Chamodya678442/5-DOF-Pick-Place-Robotic-Arm/Research Paper content/Latex_files/main.tex

\documentclass[conference]{IEEEtran}

\usepackage{cite}
\usepackage{amsmath,amsfonts}
\usepackage{amssymb}
\usepackage{graphicx}
\usepackage{url}
\usepackage{booktabs}
\usepackage{array}

\usepackage{tikz}
\usetikzlibrary{shapes.geometric, arrows.meta, positioning}

\makeatletter
\renewcommand{\subsection}{%
    \@startsection{subsection}{2}{\z@}%
    {2.5ex plus 1ex minus 0.2ex}%
    {1.0ex plus 0.2ex}%
    {\normalfont\normalsize\bfseries}%
}
\makeatother

\makeatletter
\renewcommand{\subsubsection}{%
    \@startsection{subsubsection}{3}{\z@}%
    {1.5ex plus 0.5ex minus 0.2ex}%
    {0.8ex plus 0.2ex}%
    {\normalfont\normalsize}%
}
\makeatother

\title{Design and Implementation of a 5-DOF Pick and Place Robotic Arm
}

\author{
    \IEEEauthorblockN{
        Abeywardhana S D,
        Chamodya B J,
        Hettiarachchi S M
    }
    \IEEEauthorblockA{
        Department of Computer Engineering\\
        Faculty of Engineering\\
        University of Sri Jayewardenepura\\
        Sri Lanka
    }
}

\begin{document}

\maketitle

\begin{abstract}
Automation of object handling tasks is a significant technological advancement in most of the modern world applications. This project carefully examines the design and the development of a five-degree-of-freedom (5 DOF) robotic arm which is specifically designed for automated pick-and-place operations. The main movements of the robotic arm is determined using inverse kinematics which is a mathematical process commonly used to calculate the required rotation angles of each joint based on the desired position of the end effector. The object detection system has been implemented to identify the target object and coordinate-based positioning is combined to achieve the required movements during this whole process. Mechanical and electronic simulations were also integrated and the system’s future implementations will develop this system further. This research is mainly focused on the integration of robotic kinematics, mechanical design and embedded control of the robotic arm.

\end{abstract}

\begin{IEEEkeywords}
Robotic arm, 5 DOF, Kinematics, Mechanical structure , Pick-and-place, Electronic system, Micro-controller, Object detection, Challenges and implementation

\end{IEEEkeywords}

\input{sections/introduction}

\input{sections/literature review}

\input{sections/system overview and architecture}

\input{sections/mechanical design and prototype development}

\input{sections/inverse kinematics model and angle calculation}

\input{sections/electronic system and microcontroller implementation}

\input{sections/experimental results and discussion}

\input{sections/conclusion}

\input{sections/future work}

\input{sections/acknowledgment}

\bibliographystyle{IEEEtran}
\bibliography{references}

\end{document}
