Chamodya678442/5-DOF-Pick-Place-Robotic-Arm/Research Paper content/Latex_files/sections/conclusion.tex

\section{conclusion}

This project successfully developed a 5-DOF pick-and-place robotic arm by integrating mechanical design, inverse kinematics, electronic control, and embedded programming. A conceptual mechanical structure was designed using SolidWorks to analyse the robotic arm configuration and joint arrangement. Although the initial design was developed through CAD modeling, the final prototype was implemented using a commercially available robotic arm structure to achieve reliable mechanical operation.
The inverse kinematics algorithm successfully calculated the required joint angles according to the desired end-effector positions. These calculated angles were implemented using an ESP32 microcontroller to control five servo motors and achieve coordinated robotic movement. The integration of an IR sensor enabled automated object detection, while the gripper mechanism allowed successful object handling and placement. The experimental results demonstrated that the developed system was capable of performing automated pick-and-place operations with accurate positioning and repeatable movement.
