Chamodya678442/5-DOF-Pick-Place-Robotic-Arm/Research Paper content/Latex_files/figures/3D model.jpeg

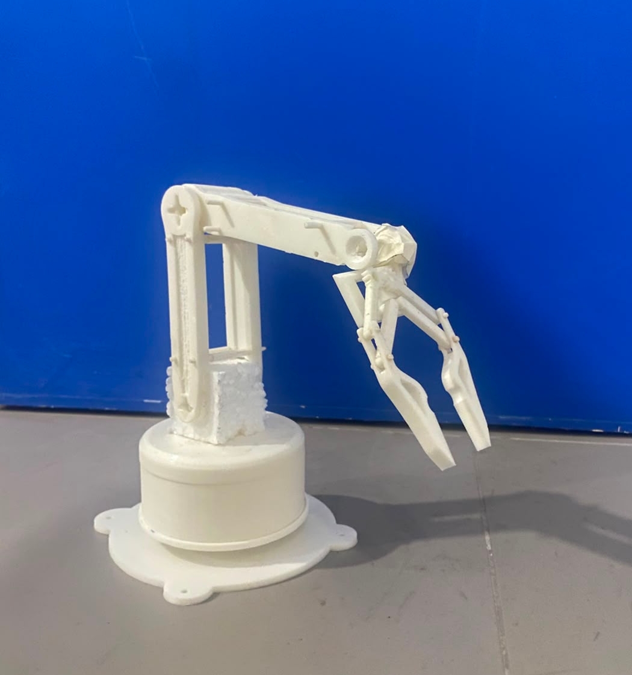
Research Paper content/Latex_files/figures/3D model.jpeg
